emmapa/proximity_kit/PK_MUV/images/acr122.jpg

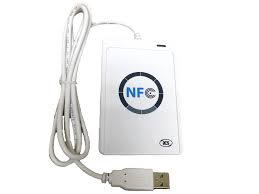
PK_MUV/images/acr122.jpg
