emmapa/proximity_kit/PK_MUV/images/back_text.jpg

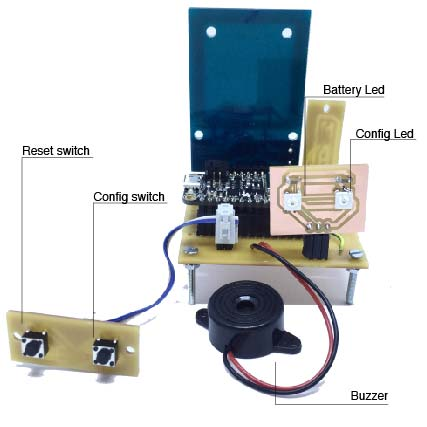
PK_MUV/images/back_text.jpg
