emmapa/proximity_kit/PK_MUV/images/config_0_0.png

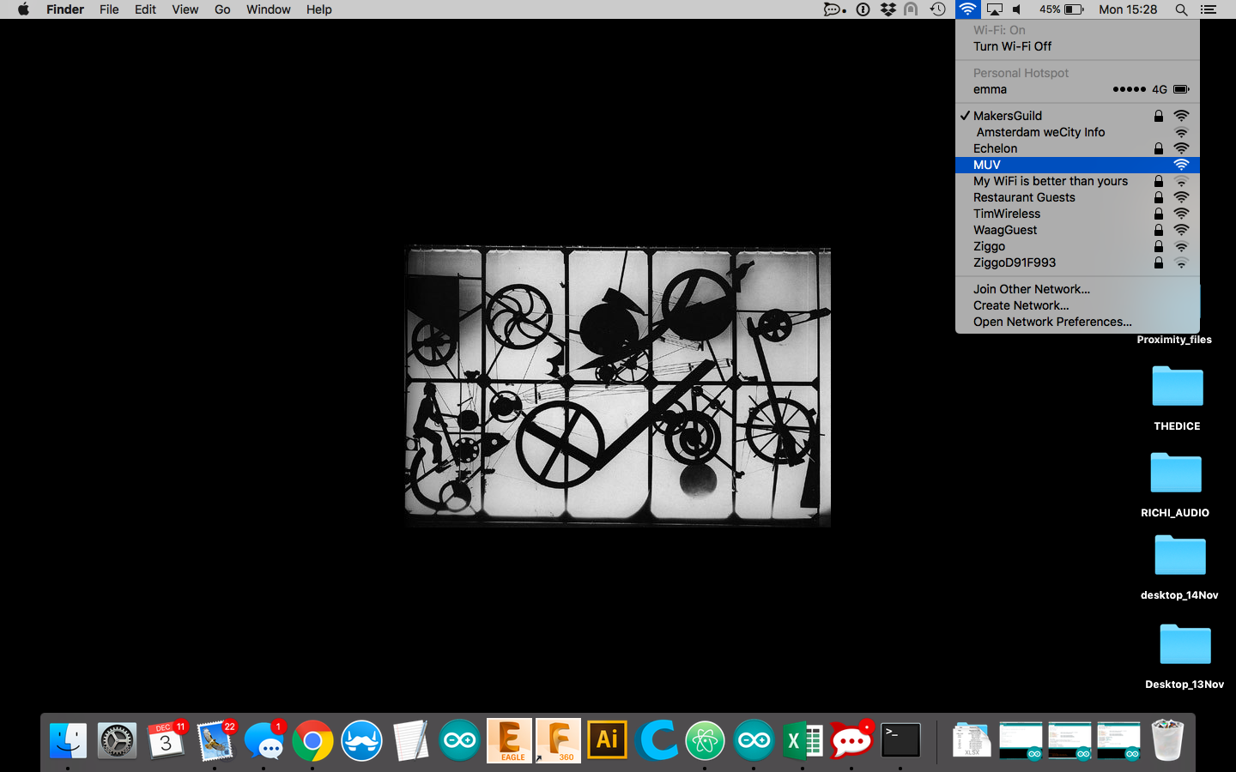
PK_MUV/images/config_0_0.png
