emmapa/proximity_kit/PK_MUV/images/config_0_1.png

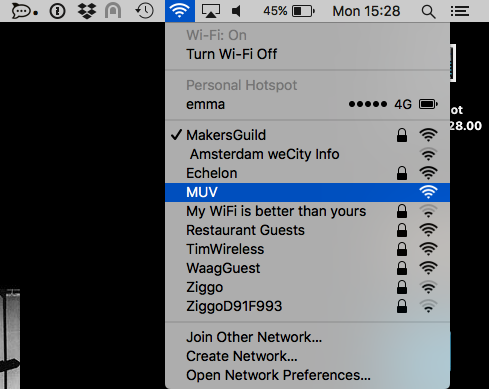
PK_MUV/images/config_0_1.png
