emmapa/proximity_kit/PK_MUV/images/config_1_1.png

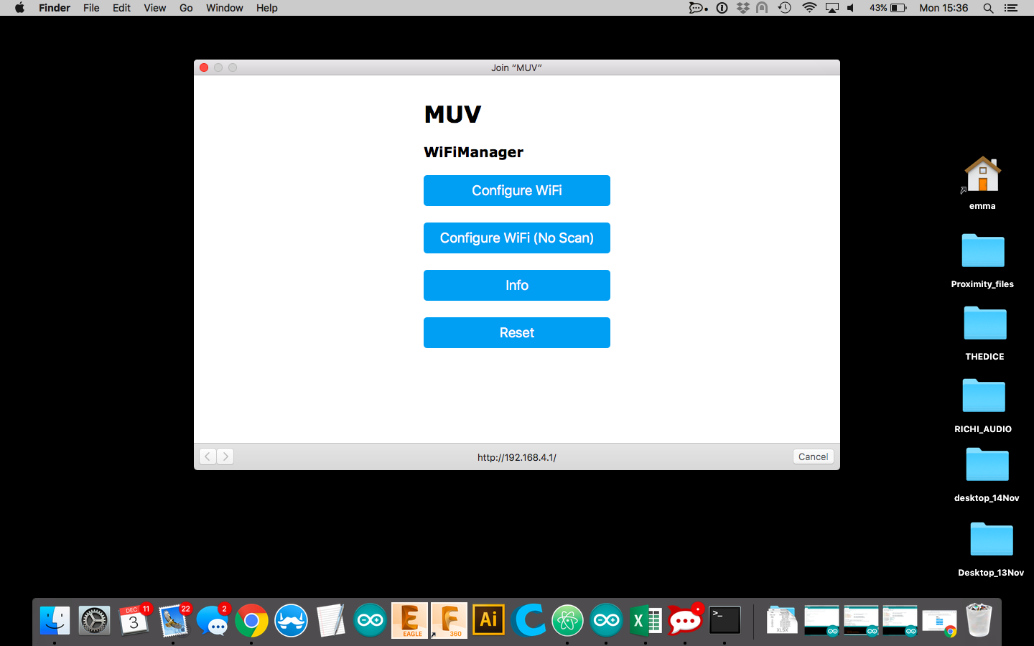
PK_MUV/images/config_1_1.png
