emmapa/proximity_kit/PK_MUV/images/config_2.png

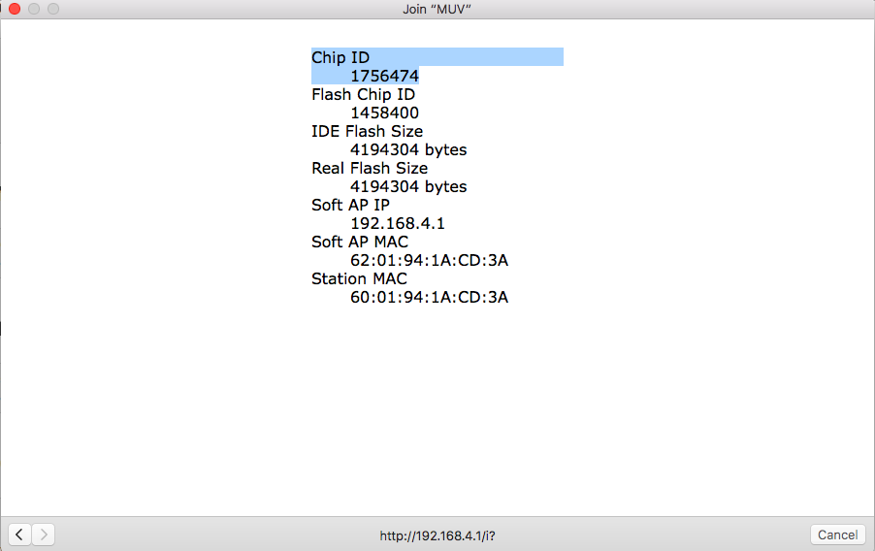
PK_MUV/images/config_2.png
