emmapa/proximity_kit/PK_MUV/images/config_3.png

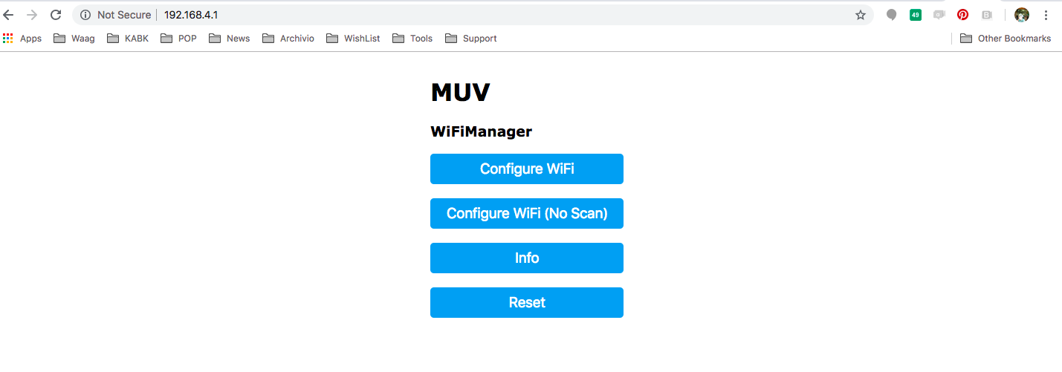
PK_MUV/images/config_3.png
