emmapa/proximity_kit/PK_MUV/images/config_4.png

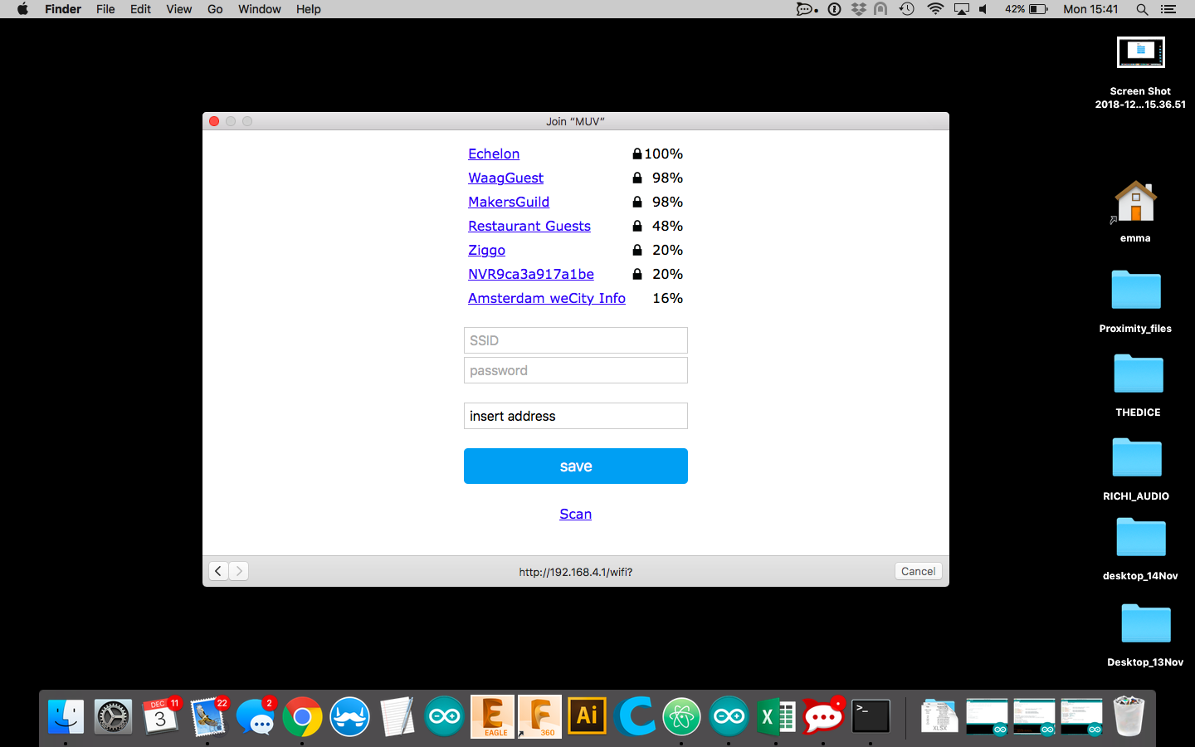
PK_MUV/images/config_4.png
