emmapa/proximity_kit/PK_MUV/images/front_text.jpg

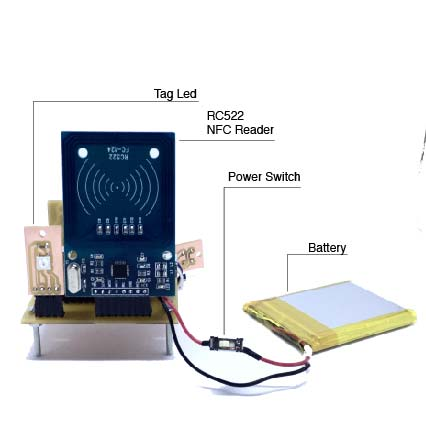
PK_MUV/images/front_text.jpg
