emmapa/proximity_kit/PK_MUV/images/led_aqua.png

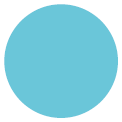
PK_MUV/images/led_aqua.png
