emmapa/proximity_kit/PK_MUV/images/led_green_green_green.png

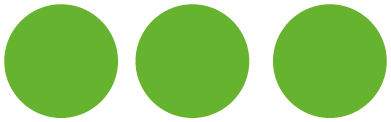
PK_MUV/images/led_green_green_green.png
