emmapa/proximity_kit/PK_MUV/images/side_text.jpg

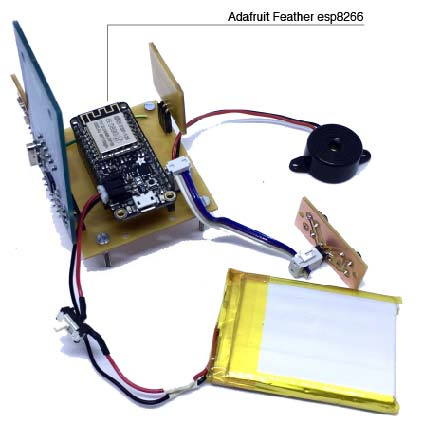
PK_MUV/images/side_text.jpg
