emmapa/proximity_kit/PK_MUV/images/Top_page.jpg

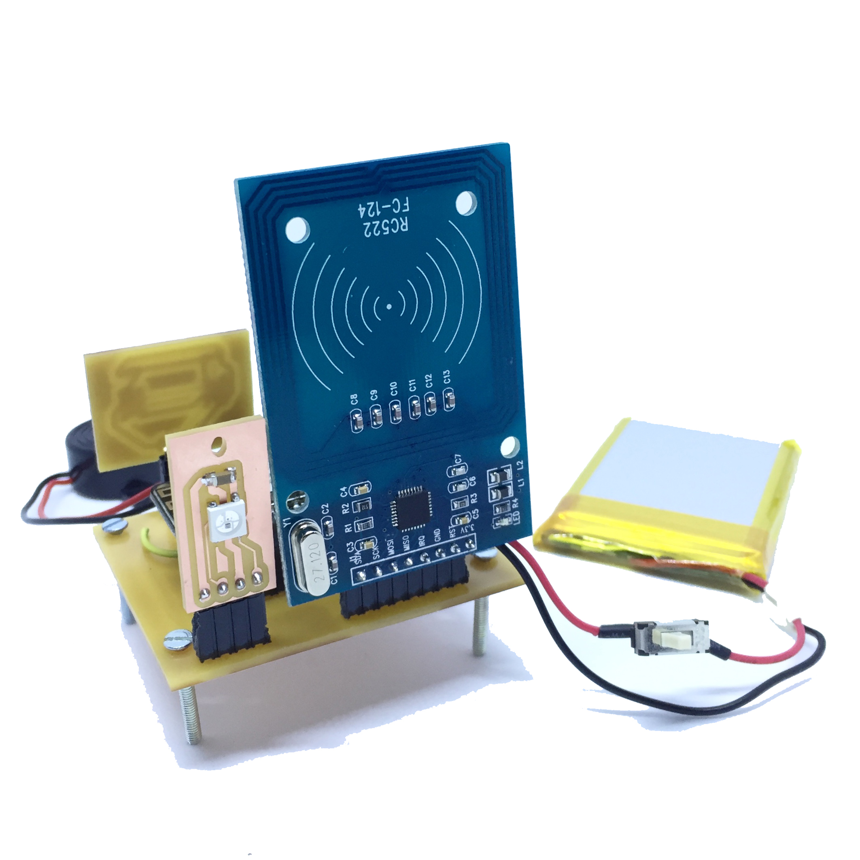
PK_MUV/images/Top_page.jpg
