emmapa/proximity_kit/PK_MUV/Tech/images/aux_PK_MUV_L1_bottom_view.png

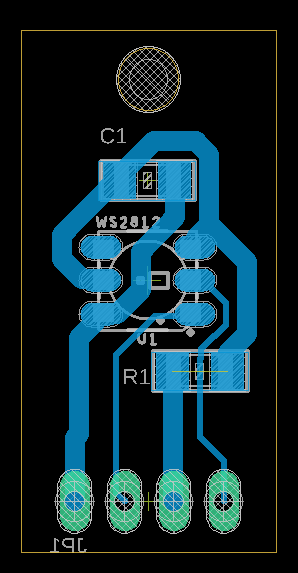
PK_MUV/Tech/images/aux_PK_MUV_L1_bottom_view.png
