emmapa/proximity_kit/PK_MUV/Tech/images/aux_PK_MUV_L2_bottom_clean.jpg

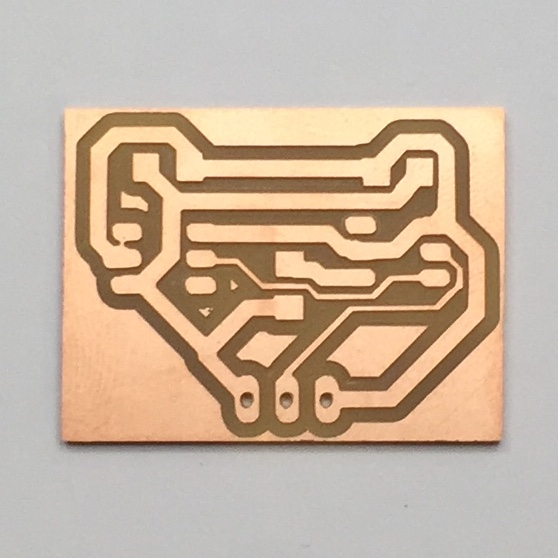
PK_MUV/Tech/images/aux_PK_MUV_L2_bottom_clean.jpg
