emmapa/proximity_kit/PK_MUV/Tech/Machinable files/PK_MUV_cut.png

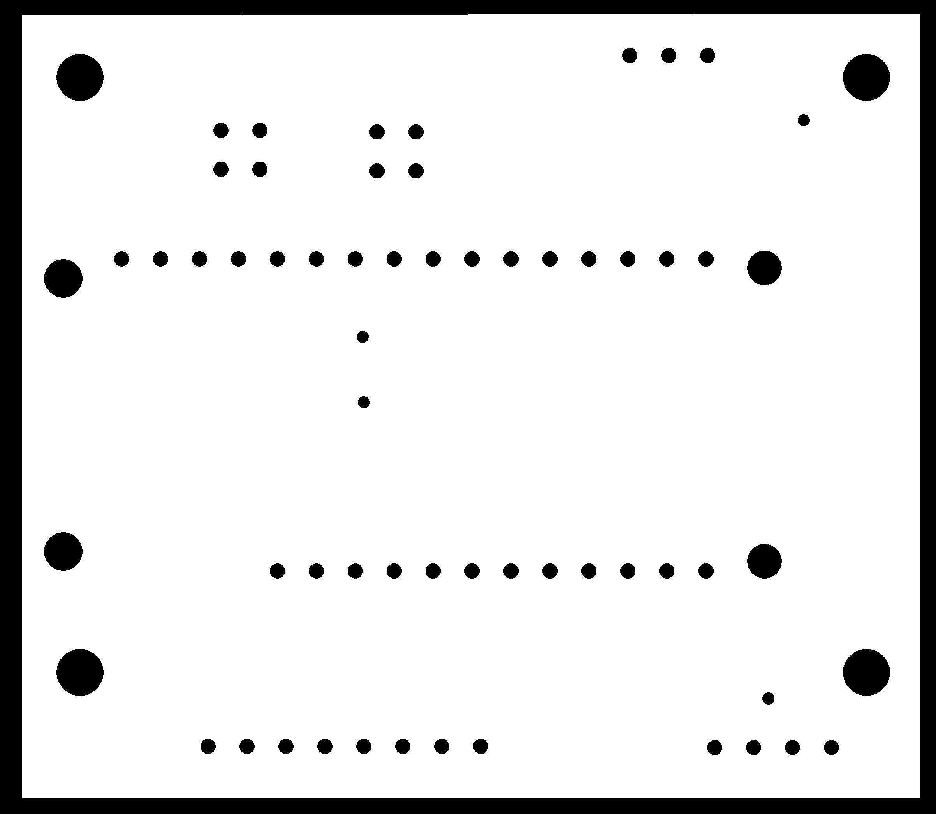
PK_MUV/Tech/Machinable files/PK_MUV_cut.png
