emmapa/proximity_kit/PK_MUV/Tech/Machinable files/PK_MUV_L2_traces.png

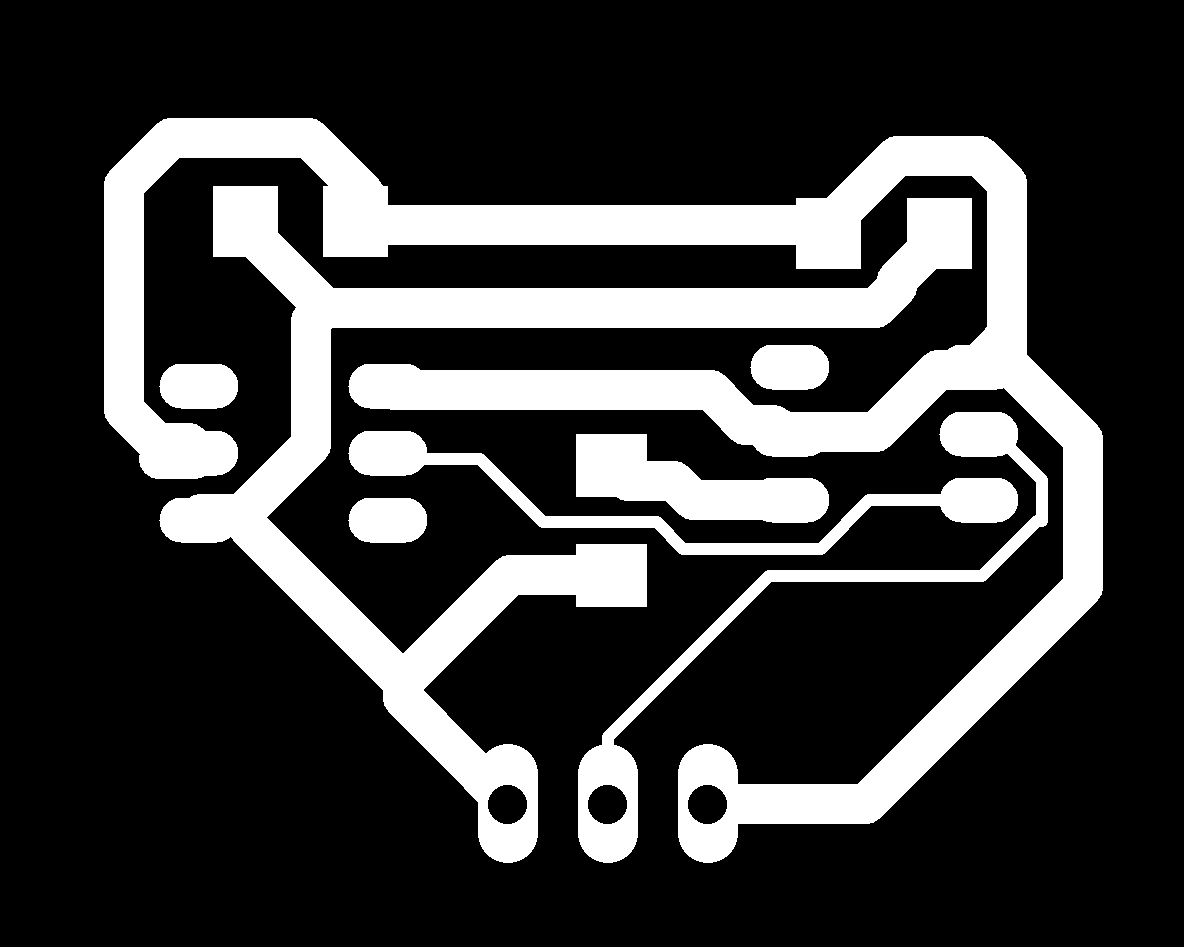
PK_MUV/Tech/Machinable files/PK_MUV_L2_traces.png
