emmapa/proximity_kit/PK_MUV/Tech/Machinable files/PK_MUV_traces.png

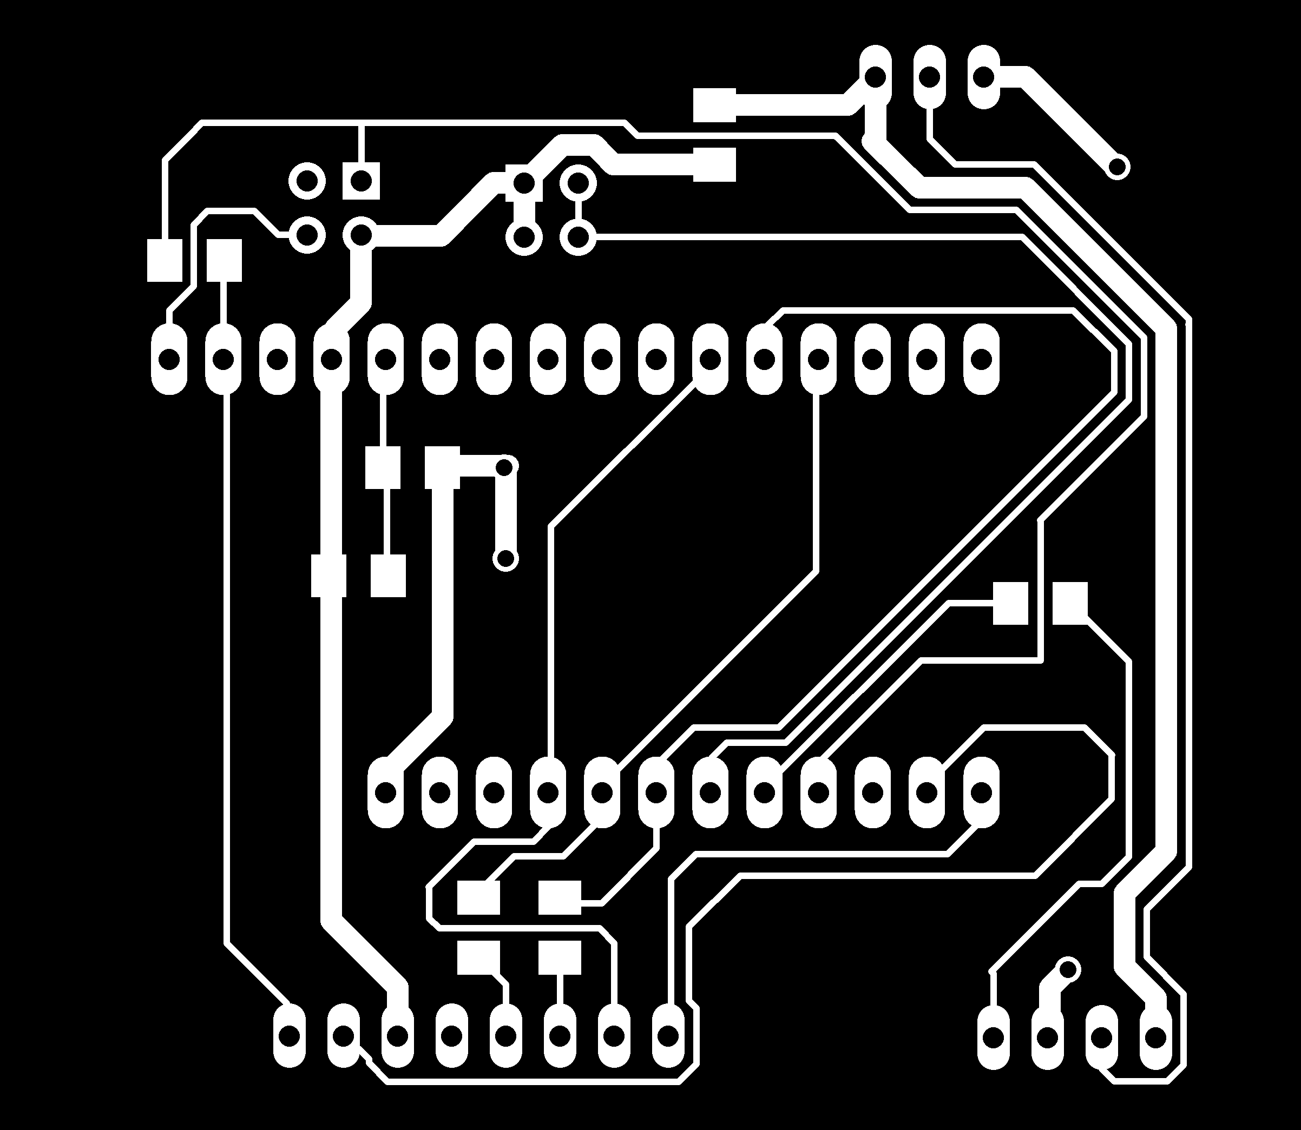
PK_MUV/Tech/Machinable files/PK_MUV_traces.png
