emmapa/proximity_kit/PK_MUV/Tech/BOM.xlsx

 |  | READ THE BOM NOTE in the repo
Purchase cost (euro) | 111.662
Cost of 1 kit (euro) | 43.8092
 | Name | Description | Amount | Supplier | Order code | Price (euro) | Minimum | Purchase Cost (euro) buying minimu amount | Cost per Kit (euro) | Link
 | Feather HUZZAH esp8266 | Adafruit Feather HUZZAH with ESP8266 WiFi (*) | 1 | Open Circuit | P2821 | 19.95 | 1 | 19.95 | 19.95 | https://opencircuit.nl/Product/12958/Adafruit-Feather-HUZZAH-with-ESP8266-WiFi
 | RC522 | NFC reader RC522 | 1 | Open Circuit | 10230 | 4.95 | 1 | 4.95 | 4.95 | https://opencircuit.nl/Product/10230/RC522-RFID-Reader-writer-module-kit-13.56MHz
PK_MUV pcb
 | Buzz | Transducer, Piezo, Leaded, min1 V, 8 mA, 90 dB, 5.5 kHz | 1 | Farnell | 1300025 | 2.15 | 1 | 2.15 | 2.15 | https://nl.farnell.com/pro-signal/abt-422-rc/piezo-transducer-leaded/dp/1300025?ost=1300025
 | JP_LEDS | Board-To-Board Connector, 2.54 mm, 3 Contacts, Receptacle, M20 Series, Through Hole, 1 Rows | 1 | Farnell | 7991924 | 0.491 | 10 | 4.91 | 0.491 | https://nl.farnell.com/harwin/m20-7820346/socket-pcb-0-1-3way/dp/7991924
 | JP_SW: | Board-To-Board Connector, Vertical, 3A, 2.54 mm, 4 Contacts, Header, WR-PHD Series, Through Hole | 1 | Farnell | 2356130 | 0.402 | 10 | 4.02 | 0.402 | https://nl.farnell.com/wurth-elektronik/61300421121/header-2-54mm-pin-tht-vertical/dp/2356130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
 | Feather header 1 | Board-To-Board Connector, 2.54 mm, 16 Contacts, Receptacle, WR-PHD Series, Through Hole, 1 Rows | 1 | Farnell | 2827905 | 1.2 | 10 | 12 | 1.2 | https://nl.farnell.com/wurth-elektronik/61301611821/connector-rcpt-16pos-1row-2-54mm/dp/2827905
 | Feather header 2 | Board-To-Board Connector, 2.54 mm, 12 Contacts, Receptacle, WR-PHD Series, Through Hole, 1 Rows | 1 | Farnell | 2827901 | 0.713 | 10 | 7.13 | 0.713 | https://nl.farnell.com/wurth-elektronik/61301211821/connector-rcpt-12pos-1row-2-54mm/dp/2827901
 | JP_LED_TAG | Board-To-Board Connector, 2.54 mm, 4 Contacts, Receptacle, M20 Series, Through Hole, 1 Rows | 1 | Farnell | 7991932 | 0.53 | 10 | 5.3 | 0.53 | https://nl.farnell.com/harwin/m20-7820446/socket-pcb-0-1-4way/dp/7991932
 | JP_NFC | Board-To-Board Connector, 2.54 mm, 8 Contacts, Receptacle, 2212S Series, Through Hole, 1 Rows | 1 | Farnell | 1593463 | 0.39 | 15 | 5.85 | 0.39 | https://nl.farnell.com/multicomp/2212s-08sg-85/socket-pcb-1-row-8way/dp/1593463
 | R1 | SMD Chip Resistor, 1 Mohm, MCWR Series, 200 V, Thick Film, package 1206, 1% | 1 | Farnell | 2447478 | 0.0162 | 10 | 0.162 | 0.0162 | https://nl.farnell.com/multicomp/mcwr12x1004ftl/res-1m-1-0-25w-thick-film/dp/2447478
 | R2 | SMD Chip Resistor, 220 kohm, CRCW Series, 200 V, Thick Film, 1206 [3216 Metric], 250 mW, 1% | 1 | Farnell | 2139620 | 0.0818 | 10 | 0.818 | 0.0818 | https://nl.farnell.com/vishay/crcw1206220kfkea/res-220k-1-0-25w-1206-thick-film/dp/2139620
 | R3/R4/R7 | SMD Chip Resistor, 0 ohm, CRCW Series, 200 V, Thick Film, 1206 [3216 Metric], 250 mW, 1% | 3 | Farnell | 1469963 | 0.0355 | 10 | 0.355 | 0.1065 | https://nl.farnell.com/vishay/crcw12060000z0ea/res-0r0-0-25w-1206-jumper/dp/1469963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
 | R5 | SMD Chip Resistor, 10 kohm, 200 V, Thick Film,1206 [3216 Metric], 250 mW, 5% | 1 | Farnell | 2057856 | 0.0617 | 10 | 0.617 | 0.0617 | https://nl.farnell.com/panasonic-electronic-components/erj8geyj103v/res-10k-5-0-25w-1206-thick-film/dp/2057856
 | R6 | SMD Chip Resistor, 470 kohm, RC Series, 200 V, Thick Film, 1206 [3216 Metric], 250 mW, 1% | 1 | Farnell | 9241108 | 0.0805 | 10 | 0.805 | 0.0805 | https://nl.farnell.com/yageo/rc1206fr-07470kl/res-470k-1-0-25w-1206-thick-film/dp/9241108
PK_MUV_L1 pcb
 | JP1 | Board-To-Board Connector, Right Angle, 2.54 mm, 4 Contacts, Header, WR-PHD Series, Through Hole | 1 | Farnell | 2356178 | 0.326 | 10 | 3.26 | 0.326 | https://nl.farnell.com/wurth-elektronik/61300411021/header-2-54mm-pin-tht-r-a-4way/dp/2356178
 | C1 | SMD Multilayer Ceramic Capacitor, Tip & Ring, 0.1 µF, 250 V, 1206 [3216 Metric], ± 10%, X7R | 1 | Farnell | 2429364 | 0.346 | 5 | 1.73 | 0.346 | https://nl.farnell.com/kemet/c1206c104karactu/cap-0-1-f-250v-10-x7r-1206/dp/2429364?st=C1206C104KARACTU
 | R1 | SMD Chip Resistor, 0 ohm, CRCW Series, 200 V, Thick Film, 1206 [3216 Metric], 250 mW, 1% | 1 | Farnell | 1469963 | 0.0355 | 10 | 0.355 | 0.0355 | https://nl.farnell.com/vishay/crcw12060000z0ea/res-0r0-0-25w-1206-jumper/dp/1469963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
 | U1 | WS2812B RGB Led, Neopixel, package 5050 | 1 | Opencircuit | 10707 | 0.195 | 10 | 1.95 | 0.195 | https://opencircuit.nl/Product/10707/WS2812B-RGB-led-10-stuks
PK_MUV_L2 pcb
 | JP1 | Board-To-Board Connector, Right Angle, 2.54 mm, 3 Contacts, Header, WR-PHD Series, Through Hole | 1 | Farnell | 2356177 | 0.488 | 10 | 4.88 | 0.488 | https://nl.farnell.com/wurth-elektronik/61300311021/header-2-54mm-pin-tht-r-a-3way/dp/2356177
 | C1=C2 | SMD Multilayer Ceramic Capacitor, Tip & Ring, 0.1 µF, 250 V, 1206 [3216 Metric], ± 10%, X7R | 2 | Farnell | 2429364 | 0.346 | 5 | 1.73 | 0.692 | https://nl.farnell.com/kemet/c1206c104karactu/cap-0-1-f-250v-10-x7r-1206/dp/2429364?st=C1206C104KARACTU
 | U1=U2 | WS2812B RGB Led, Neopixel, package 5050 | 2 | Opencircuit | 10707 | 0.195 | 10 | 1.95 | 0.39 | https://opencircuit.nl/Product/10707/WS2812B-RGB-led-10-stuks
PK_MUV_sw pcb
 | JP1 | Board-To-Board Connector, 2.54 mm, 4 Contacts, Header, WR-PHD Series, Surface Mount, 2 Rows | 1 | Farnell | 2356217 | 0.654 | 10 |  |  | https://nl.farnell.com/wurth-elektronik/61000421121/header-2-54mm-pin-smt-4way/dp/2356217
 | sw1 = sw2 | Tactile Switch, Through Hole, Non Illuminated, 50 mA, 12 V, 160 gf | 2 | Farnell | 2402405 | 1.26 | 5 | 6.3 | 2.52 | https://nl.farnell.com/wurth-elektronik/430186043716/switch-tactile-0-05a-12vdc-tht/dp/2402405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
Power
 | battery | Lithium Ion Battery - 3.7v 2000mAh | 1 | Open Circuit |  |  | 1 | 0 | 0 | https://www.kiwi-electronics.nl/lithium-ion-polymer-battery-3-7v-2500mAh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
 | power sw | Slide Switch, SPDT, Through Hole, STSS9 Series, 500 mA | 1 | Farnell | 1123875 | 0.645 | 5 | 3.225 | 0.645 | https://nl.farnell.com/alps/stsss9121/slide-switch-sp-2-pos-vert/dp/1123875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
 | extention cable | JST-PH Battery Extension Cable - 500mm | 1 | Kiwi-electronics | CBL-JSTPH-50 | 2.25 | 1 | 2.25 | 2.25 | https://www.kiwi-electronics.nl/jst-ph-accu-verlengkabel-50cm?search=JST-PH%20&description=true
 | JST battery header | Wire-To-Board Connector, Right Angle, 2 mm, 2 Contacts, Header, PH Series, Surface Mount, 1 Rows | 1 | Farnell | 9492615 | 0.467 | 10 | 4.67 | 0.467 | https://nl.farnell.com/jst-japan-solderless-terminals/s2b-ph-sm4-tb-lf-sn/connector-header-smt-r-a-2mm-2way/dp/9492615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
 | shring tubes | Heat Shrink Tubing, Flame Retardant, 2:1, 0.094 ", 2.4 mm, Black, 3.94 ft, 1.2 m | 1 | Farnell | 1190779 | 1.21 | 5 | 6.05 | 1.21 | https://nl.farnell.com/pro-power/sp24-1-2-black/heat-shrink-1-2mtr/dp/1190779
Extra
 | flat cable | Ribbon Cable, Round Conductor Flat, Per Metre, Unscreened, 16 Core, 28 AWG, 0.072 mm² | 1 | Farnell | 297318 | 2.34 | 1 | 2.34 | 2.34 | https://nl.farnell.com/3m/3365-16/ribbon-cable-16way-per-m/dp/297318
 | connector for flat cable | Wire-To-Board Connector, 2.54 mm, 4 Contacts, Receptacle, Quickie III 71600 Series, IDC / IDT | 2 | Farnell | 2886085 | 0.391 | 5 | 1.955 | 0.782 | https://nl.farnell.com/amphenol-icc-fci/71600-104lf/connector-rcpt-4pos-2row-2-54mm/dp/2886085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
