emmapa/proximity_kit/PK_MUV/Tech/Eagle files/PK_MUV_L2.brd

## EAGLE design PK_MUV/Tech/Eagle files/PK_MUV_L2.brd (2018-12-04)

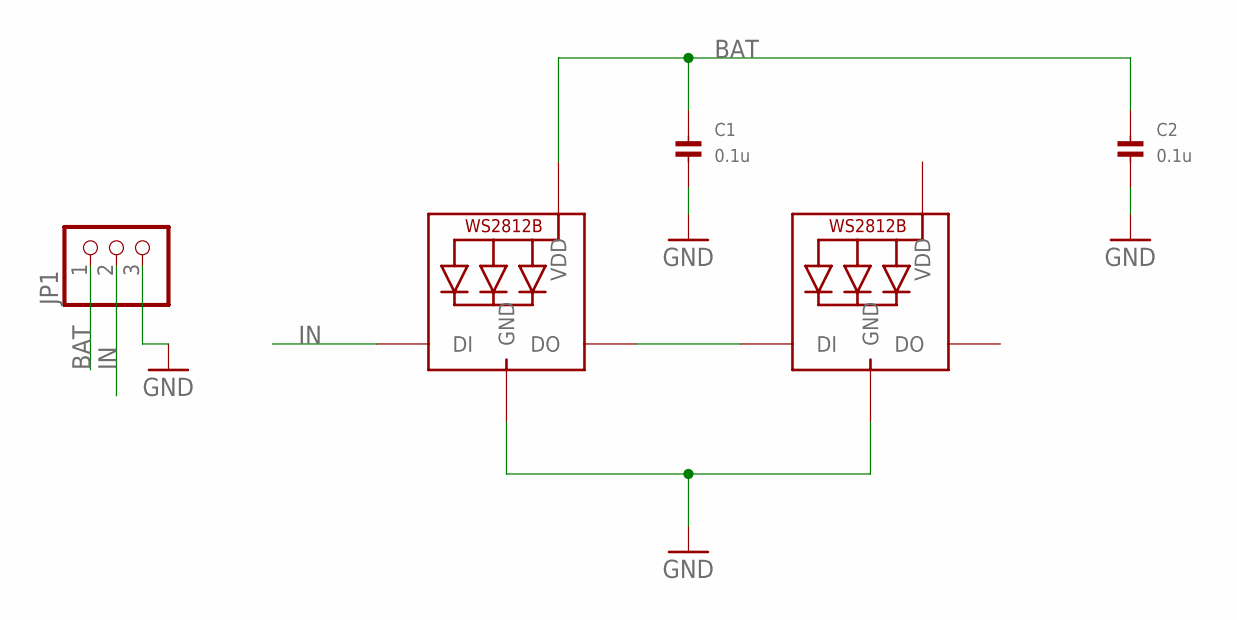
[picture p61: schematic PK_MUV_L2.sch]

Parts:
C1, C2: 0.1u; 1206
JP1: HEADER-1X3; 1X03_OVAL
LED1, LED2: WS2812B_5050N; WS2812B-NARROW

Connections:
BAT: C1.1, C2.1, JP1.1, LED1.1-VDD (VDD)
GND: C1.2, C2.2, JP1.3, LED1.3-GND (GND), LED2.3-GND (GND)
IN: JP1.2, LED1.4-DIN (DI)
unnamed: LED1.2-DOUT (DO), LED2.4-DIN (DI)
VDD: LED2.1-VDD (VDD)

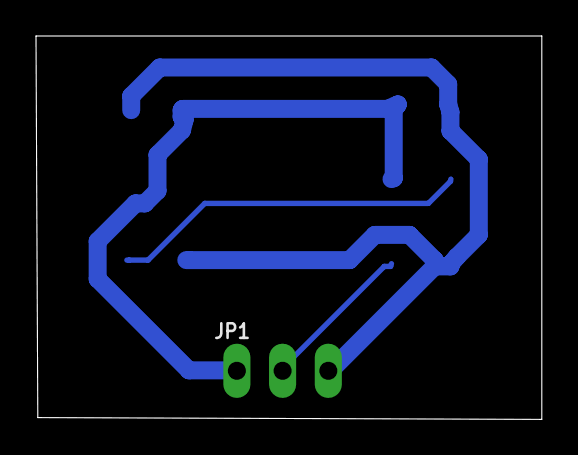
[picture p62: board PK_MUV_L2.brd from above]

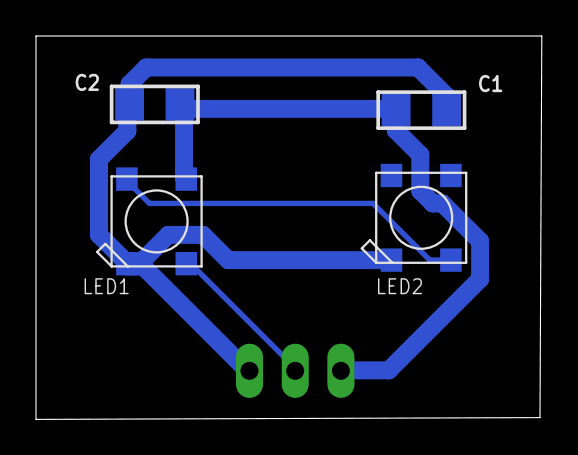
[picture p63: board PK_MUV_L2.brd from below]

Board: 2 copper layers, 28.1 x 21.3 mm, 5 parts (4 on the bottom side), 4 nets.
