emmapa/proximity_kit/PK_MUV/Tech/Eagle files/PK_MUV.brd

## EAGLE design PK_MUV/Tech/Eagle files/PK_MUV.brd (2018-12-02)

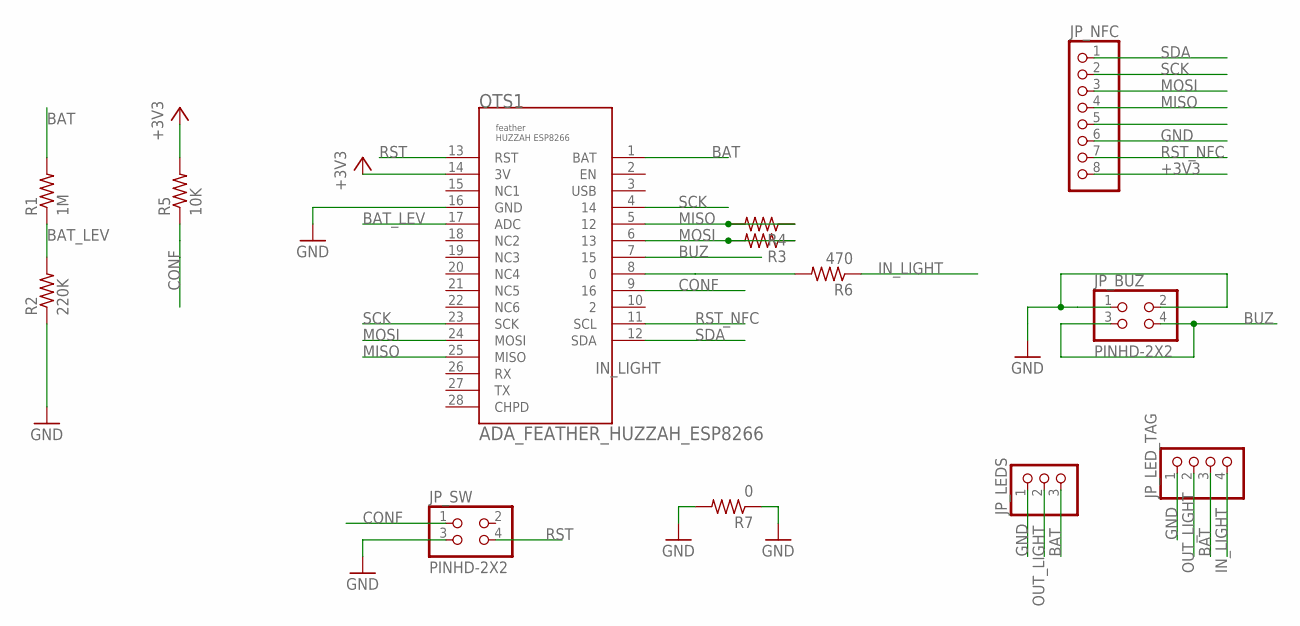
[picture p66: schematic PK_MUV.sch]

Parts:
JP_BUZ: PINHD-2X2; 2X2
JP_LEDS: HEADER-1X3; 1X03_OVAL
JP_LED_TAG: HEADER-1X4; 1X04_OVAL
JP_NFC: HEADER-1X8; 1X08_OVAL
JP_SW: PINHD-2X2; 2X2
OTS1: ADA_FEATHER_HUZZAH_ESP8266
R1: 1M; M1206
R2: 220K; M1206
R3, R4: R-US_M1206; M1206
R5: 10K; M1206
R6: 470; M1206
R7: 0; M1206

Connections:
+3V3: JP_NFC.8, OTS1.14 (3V), R5.2
BAT: JP_LEDS.3, JP_LED_TAG.3, OTS1.1 (BAT), R1.2
BAT_LEV: OTS1.17 (ADC), R1.1, R2.2
BUZ: JP_BUZ.3, JP_BUZ.4, OTS1.7 (15)
CONF: JP_SW.1, OTS1.9 (16), R5.1
GND: JP_BUZ.1, JP_BUZ.2, JP_LEDS.1, JP_LED_TAG.1, JP_NFC.6, JP_SW.3, OTS1.16 (GND), R2.1, R7.1, R7.2
IN_LIGHT: JP_LED_TAG.4, R6.1
MISO: JP_NFC.4, OTS1.5 (12), OTS1.25 (MISO), R4.1, R4.2
MOSI: JP_NFC.3, OTS1.6 (13), OTS1.24 (MOSI), R3.1, R3.2
unnamed: OTS1.8 (0), R6.2
OUT_LIGHT: JP_LEDS.2, JP_LED_TAG.2
RST: JP_SW.4, OTS1.13 (RST)
RST_NFC: JP_NFC.7, OTS1.11 (SCL)
SCK: JP_NFC.2, OTS1.4 (14), OTS1.23 (SCK)
SDA: JP_NFC.1, OTS1.12 (SDA)
USB: OTS1.3 (USB)

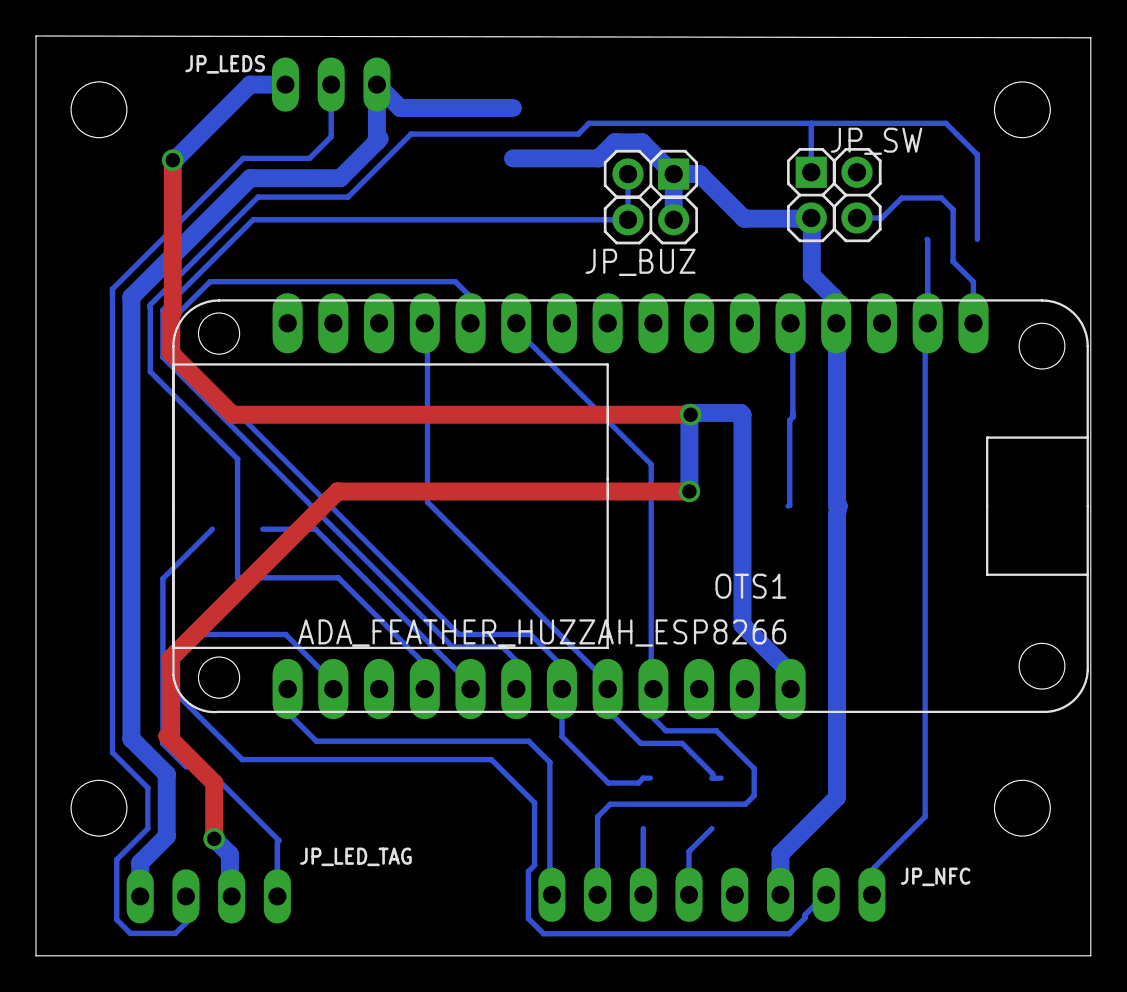
[picture p67: board PK_MUV.brd from above]

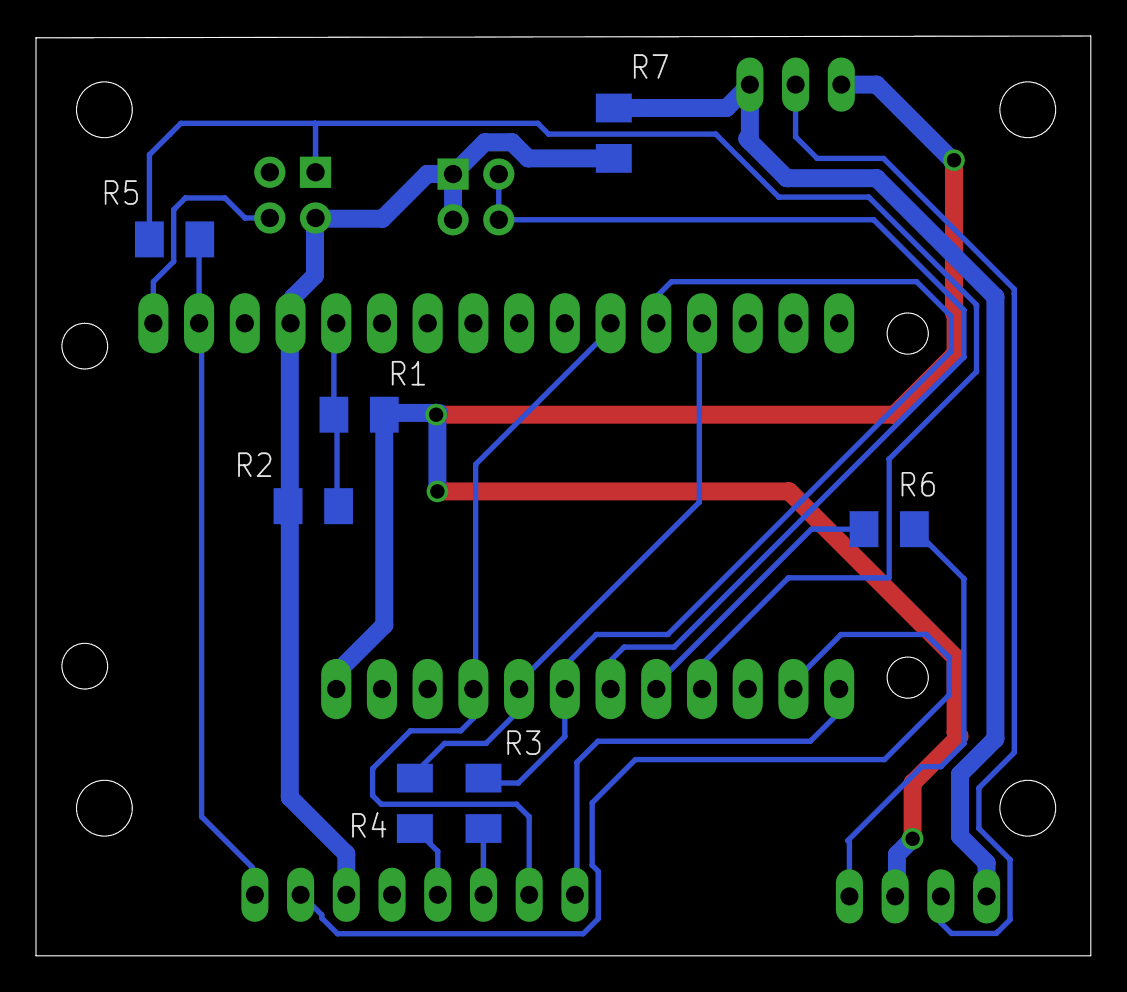
[picture p68: board PK_MUV.brd from below]

Board: 2 copper layers, 58.6 x 51.1 mm, 13 parts (7 on the bottom side), 15 nets.
