emmapa/proximity_kit/(commit log)

2018-12-02 Update tech
    [PK_MUV.brd, PK_MUV.sch, PK_MUV_L1.brd, PK_MUV_L1.sch, PK_MUV_L2.brd, PK_MUV_L2.sch, PK_MUV_sw.brd, PK_MUV_sw.sch]
2019-03-18 png L1
    [BOM.xlsx]
